olegv142/STM32AllProgrammable/(commit log)

2020-04-05 Change device class to TMC and increment PID. Now it is detected as USBTMC on Windows.
2020-04-05 Device class fixed. Now it is visible by NI MAX.
2020-04-05 Using 0xFFFE as PID, and TeraSense as manufacturer
2020-04-08 SPI flash doc added
2020-04-08 Using device specific command prefix for :ECHO
2020-04-08 Empty message case added to echo test
2020-04-08 Print IDN string before starting echo test loop
2020-04-08 STM32 and board doc added
2020-04-11 Spartan 6 board schema added
2020-04-11 SPI clk freq lowered to 9MHz
2020-04-11 Never skip though ':' since its subcommand separator
    [str_util.h]
2020-04-12 Script showing current FPGA status
2020-04-13 SPI port echo test
2020-04-13 API for SPI port transactions
2020-04-13 SPI gate module
2020-04-13 FPGA host controlled LED blinking test
2020-04-13 MCU stuff is moved to STM32 folder
2020-04-13 Forgotten SPI gate module
2020-04-13 Force flash CS high to avoid glitches
    [pl.c]
2020-04-13 Using 8 bit SPI gate internal data bus
2020-04-13 Lower SPI frequency
2020-04-13 SPI data transactions API updated
2020-04-13 LED blinking test updated
2020-04-13 More HAL drivers
2020-04-14 Filtering CS glitches
2020-04-14 Back to 9 MHz SPI clock
2020-04-15 DCMI test frames generator
2020-04-15 Ensure DCMI frame size is the multiple of 4 bytes
2020-04-15 Prototype photo
2020-04-15 Schematic doc
2020-04-16 Detect FPGA configuration reset
    [pl.c]
2020-04-17 Redundant SPI gate signal removed, one more test port added
2020-04-19 Revert "DCMI gate for transmitters multiplexing"
    This reverts commit 89cce554177e859c0b2ba628897a57cbf0497f77.
    [echo.v]
2020-04-19 Cosmetic changes in trace captions formatting
